WillemsIndustries/Something-bridge/Software/Software flow chart.png

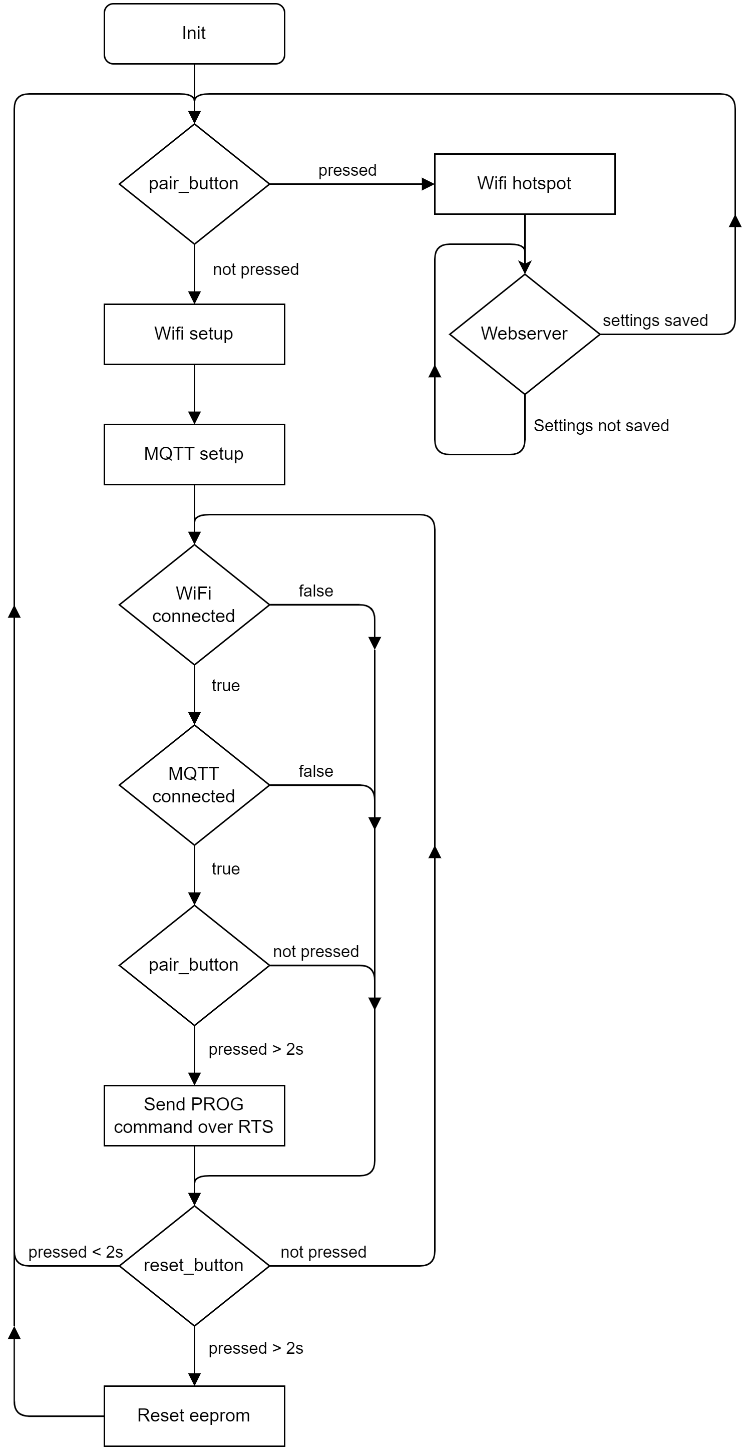
Software/Software flow chart.png
