WillemsIndustries/Something-bridge/Housing/Behuizing v2.1.STL

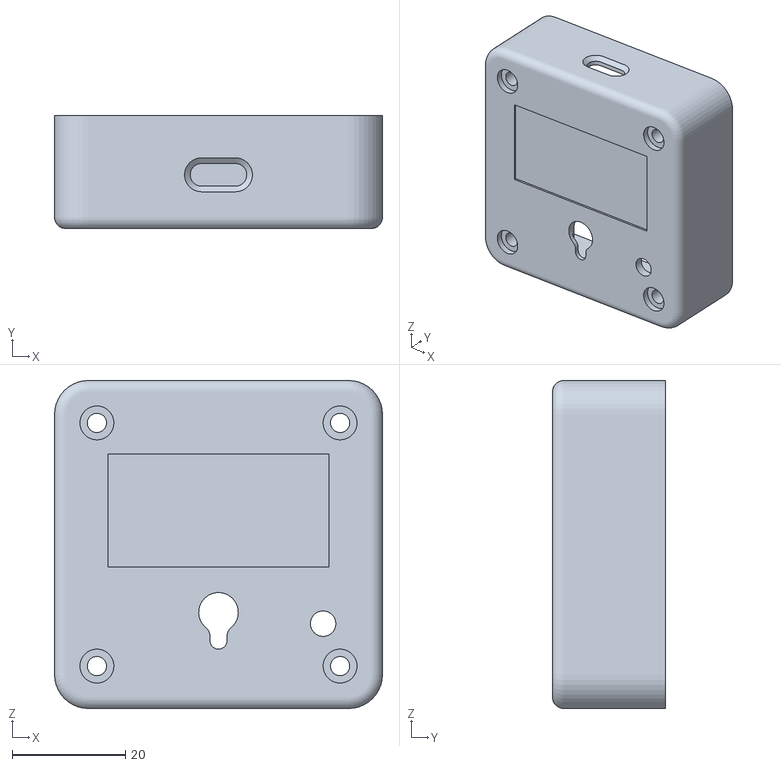
[picture p2: CAD file, 2024-01-18]
Housing/Behuizing v2.1.STL
58.0 x 20.0 x 58.0
