WillemsIndustries/Something-bridge/Housing/Deksel v2.STL

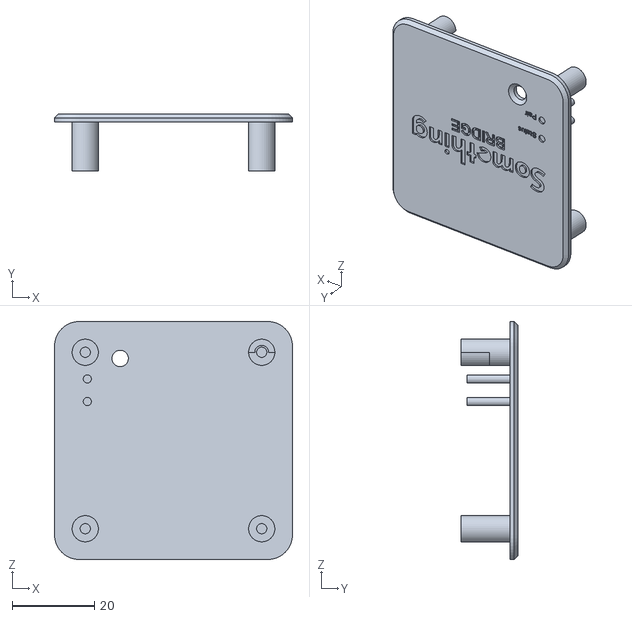
[picture p3: CAD file, 2024-01-18]
Housing/Deksel v2.STL
58.0 x 14.0 x 58.0
