WillemsIndustries/Something-bridge/Schematic.pdf

## ESP8266 ESP-12F

## ANTENNA MODULE

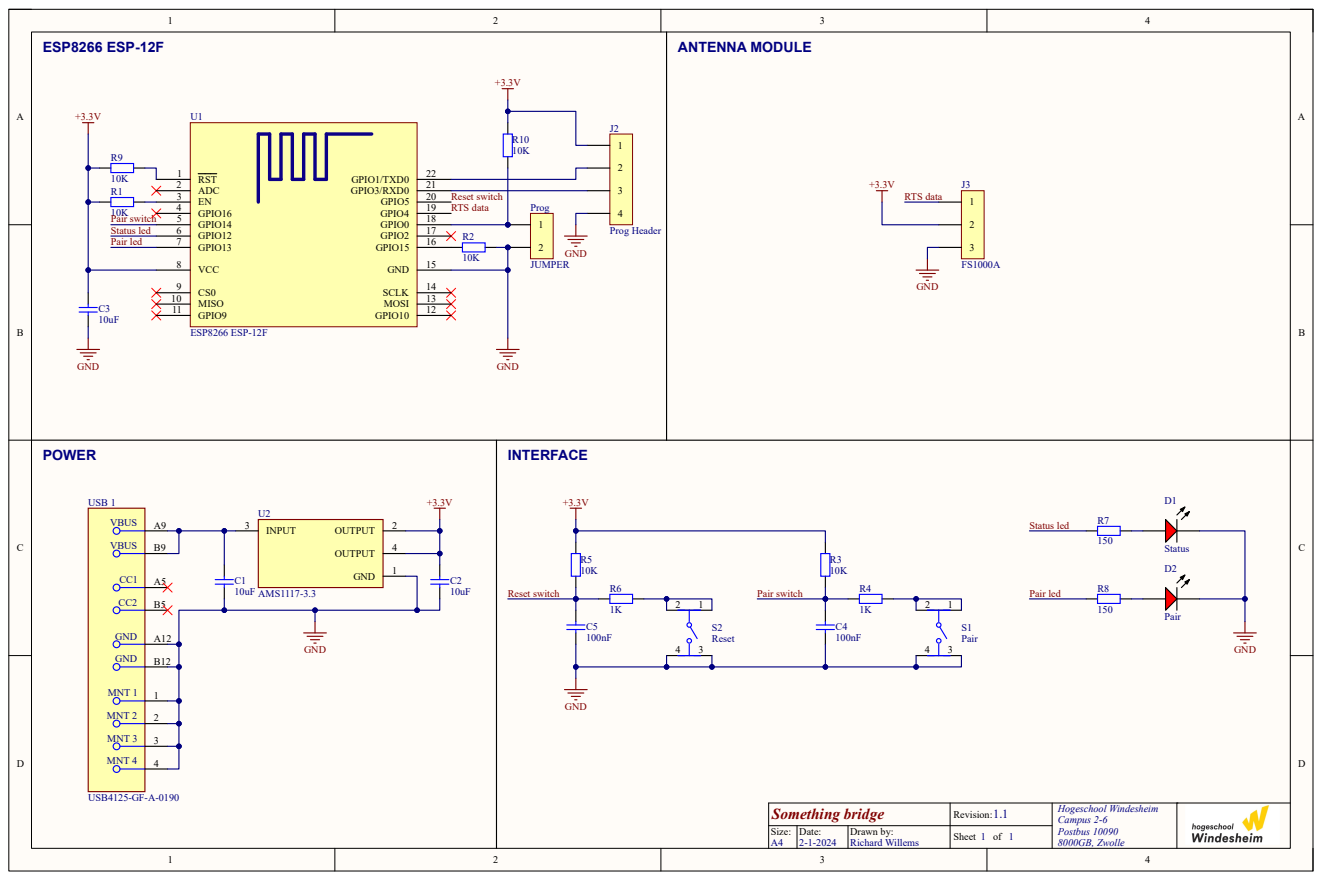
[picture p4: page 1]
