WillemsIndustries/Something-bridge/Quick start guide (Dutch).pdf

### Quick-Start Guide

WORKS VIA MQTT WITH
Dutch

## Wifi instellingen

1
Houd de drukknop op de voorkant van de bridge ingedrukt en stop vervolgens de stekker in het stopcontant. Er gaan nu 2 lampjes branden.
2
Ga op uw smartphone of computer naar de wifi-instellingen en verbind met het Something bridge netwerk.
3
Scan de QR-code of ga in uw webbrowser naar:

http://192.168.1.1/

4
Selecteer het wifi netwerk waar u mee wilt verbinden en vul het wachtwoord in. Druk vervolgens op Opslaan en
opnieuw opstarten
5
De Something bridge start nu opnieuw op en maakt
verbindingen met het internet.

## Instellen Home assistant

1
Open uw home assistant omgeving op uw smartphone of computer en ga naar Instellingen>Add-ons en klik op de knop Add-on winkel.
2
Vervolgens zoek naar MQTT, selecteer de Mosquitto broker Add-on en installeer deze.

3
Wanneer de installatie voltooid is, open de Configuratie tab.
4
Vul vervolgens onder het kopje Logins de inlog gegeven in. Deze bevinden zich aan de
onderzijde van de bridge.
- username: something bridge password: wachtwoord
5
Wanneer dit gelukt is druk op OPSLAAN en ga weer terug
naar de Informatie tab.

6
Druk vervolgens op STARTEN en wacht tot de Add-on gestart is.
7
Ga nu terug naar de Instellingen en open
Apparaten & diensten.
8
Ga nu onder het kopje Ontdekt naar MQTT en druk op de knop CONFIGUREREN.
9
Druk vervolgens op VERZENDEN en daarna op VOLTOOIEN. Home Assistant is nu volledig ingesteld. De Something bridge zal nu automatisch verschijnen in uw Home assistant dashboard.

## Koppelen van de rolluiken

1
Zet het rolluik waar u mee wilt verbinden in de pair modes door 5 seconden op de PROG-knop van de Somfy afstandsbediening te drukken. Het rolluik beweegt nu op en neer.
2
Voor het koppelen met het rolluik drukt u nu het aantal van de groep waar u mee wilt verbinden en houd u bij het laatste keer drukken de pairknop 5 seconden vast.
Voorbeeld
Voor het koppelen met groep 3 druk eest 2 keer kort op de pairknop. Druk vervolgens nog 1 keer maar houdt de knop nu 5 seconden ingedrukt.

3
Wanneer het rolluik weer op en neer beweegt, is het koppelen gelukt.
Extra informatie
Er zijn 5 rolluik groepen en er kunnen meerdere rolluiken aan 1 groep gekoppeld worden.
Om een rolluik weer los te koppelen volg de zelfde stappen.
Betekenis | Status led | Pair led
Configuratie stand | Aan | Aan
Verbinden met wifi | Knippert 1x | Uit
Verbinden met HA (MQTT) | Knippert 2x | Uit
Alles verbonden | Aan | Uit
Koppelen met rolluik * | Aan | Knippert *x
RTS commando verstuurd | Aan | Knippert

## Betekenis leds

## Resetten en herstarten

Herstarten
Wanneer u de bridge wilt herstarten druk met 1 keer kort op de reset knop aan de onderzijde van de bridge. Resetten
Wanneer u de bridge terug wilt zetten naar de fabrieksinstellingen, houd de knop aan de onderzijde van de bridge 5 seconden ingedrukt.
Let op!
Het gat voor de resetknop is niet met de hand in te drukken, gebruik hier voor een pen of een dunne schroevendraaier.

## In de doos

1 | Something bridge
1 | USB-C naar USB-A kabel
1 | 5V usb adapter
1 | Quick-Start Guide
